jcalvinowens/ledboard/prod/v020-BOM.csv

ID | Name | Designator | Footprint | Quantity | Manufacturer Part | Manufacturer | Supplier | Supplier Part | Price
1 | 4.7uH | L1 | IND-SMD_L7.0-W6.6 | 1 | MWSA0603S-4R7MT | Sunlord(顺络) | LCSC | C408447 | 0.015
2 | HL-A-3014H416W-S1-08HL-HR3_C210338 | LED1,LED2,LED3,LED4,LED5,LED6,LED7,LED8,LED9,LED10,LED11,LED12,LED13,LED14,LED15,LED16,LED17,LED18,LED19,LED20,LED21,LED22,LED23,LED24,LED25,LED26,LED27,LED28,LED29,LED30,LED31,LED32,LED33,LED34,LED35,LED36,LED37,LED38,LED39,LED40,LED41,LED42,LED43,LED44,LED45,LED46,LED47,LED48,LED49,LED50,LED51,LED52,LED53,LED54,LED55,LED56,LED57,LED58,LED59,LED60,LED61,LED62,LED63,LED64,LED65,LED66,LED67,LED68,LED69,LED70,LED71,LED72,LED73,LED74,LED75,LED76,LED77,LED78,LED79,LED80,LED81,LED82,LED83,LED84,LED85,LED86,LED87,LED88,LED89,LED90,LED91,LED92,LED93,LED94,LED95,LED96,LED97,LED98,LED99,LED100,LED101,LED102,LED103,LED104,LED105,LED106,LED107,LED108,LED109,LED110,LED111,LED112,LED113,LED114,LED115,LED116,LED117,LED118,LED119,LED120,LED121,LED122,LED123,LED124,LED125,LED126,LED127,LED128 | LED3014-RD | 128 | HL-A-3014H416W-S1-08HL-HR3 | Hongli Zhihui (HONGLITRONIC) | LCSC | C210338 | 0.002
3 | HL-A-3014H416W-S1-08HL-HR3_C210338 | LED129,LED130,LED131,LED132,LED133,LED134,LED135,LED136,LED137,LED138,LED139,LED140,LED141,LED142,LED143,LED144,LED145,LED146,LED147,LED148,LED149,LED150,LED151,LED152,LED153,LED154,LED155,LED156,LED157,LED158,LED159,LED160,LED161,LED162,LED163,LED164,LED165,LED166,LED167,LED168,LED169,LED170,LED171,LED172,LED173,LED174,LED175,LED176,LED177,LED178,LED179,LED180,LED181,LED182,LED183,LED184,LED185,LED186,LED187,LED188,LED189,LED190,LED191,LED192,LED193,LED194,LED195,LED196,LED197,LED198,LED199,LED200,LED201,LED202,LED203,LED204,LED205,LED206,LED207,LED208,LED209,LED210,LED211,LED212,LED213,LED214,LED215,LED216,LED217,LED218,LED219,LED220,LED221,LED222,LED223,LED224,LED225,LED226,LED227,LED228,LED229,LED230,LED231,LED232,LED233,LED234,LED235,LED236,LED237,LED238,LED239,LED240,LED241,LED242,LED243,LED244,LED245,LED246,LED247,LED248,LED249,LED250,LED251,LED252,LED253,LED254,LED255,LED256 | LED3014-RD | 128 | HL-A-3014H416W-S1-08HL-HR3 | Hongli Zhihui (HONGLITRONIC) | LCSC | C210338 | 0.002
4 | HL-A-3014H416W-S1-08HL-HR3_C210338 | LED257,LED258,LED259,LED260,LED261,LED262,LED263,LED264,LED265,LED266,LED267,LED268,LED269,LED270,LED271,LED272,LED273,LED274,LED275,LED276,LED277,LED278,LED279,LED280,LED281,LED282,LED283,LED284,LED285,LED286,LED287,LED288,LED289,LED290,LED291,LED292,LED293,LED294,LED295,LED296,LED297,LED298,LED299,LED300,LED301,LED302,LED303,LED304,LED305,LED306,LED307,LED308,LED309,LED310,LED311,LED312,LED313,LED314,LED315,LED316,LED317,LED318,LED319,LED320,LED321,LED322,LED323,LED324,LED325,LED326,LED327,LED328,LED329,LED330,LED331,LED332,LED333,LED334,LED335,LED336,LED337,LED338,LED339,LED340,LED341,LED342,LED343,LED344,LED345,LED346,LED347,LED348,LED349,LED350,LED351,LED352,LED353,LED354,LED355,LED356,LED357,LED358,LED359,LED360,LED361,LED362,LED363,LED364,LED365,LED366,LED367,LED368,LED369,LED370,LED371,LED372,LED373,LED374,LED375,LED376,LED377,LED378,LED379,LED380,LED381,LED382,LED383,LED384 | LED3014-RD | 128 | HL-A-3014H416W-S1-08HL-HR3 | Hongli Zhihui (HONGLITRONIC) | LCSC | C210338 | 0.002
5 | 2N7002AK | Q1,Q10,Q19,Q28,Q37,Q46,Q55,Q64,Q2,Q3,Q4,Q5,Q6,Q7,Q8,Q9,Q11,Q12,Q13,Q14,Q15,Q16,Q17,Q18,Q20,Q21,Q22,Q23,Q24,Q25,Q26,Q27,Q29,Q30,Q31,Q32,Q33,Q34,Q35,Q36,Q38,Q39,Q40,Q41,Q42,Q43,Q44,Q45,Q47,Q48,Q49,Q50,Q51,Q52,Q53,Q54,Q56,Q57,Q58,Q59,Q60,Q61,Q62,Q63 | SOT-23_L2.9-W1.3-P1.90-LS2.4-BR | 64 | 2N7002AK | YFW(佑风微) | LCSC | C2898356 | 0.003
6 | AP2301B | Q65,Q66,Q67,Q68,Q69,Q70 | SOT-23-3_L2.9-W1.3-P1.90-LS2.4-TR | 6 | AP2301B | ALLPOWER(铨力) | LCSC | C2763847 | 0.003
7 | 3.3K | R1,R10,R19,R28,R37,R46,R55,R64,R2,R3,R4,R5,R6,R7,R8,R9,R11,R12,R13,R14,R15,R16,R17,R18,R20,R21,R22,R23,R24,R25,R26,R27,R29,R30,R31,R32,R33,R34,R35,R36,R38,R39,R40,R41,R42,R43,R44,R45,R47,R48,R49,R50,R51,R52,R53,R54,R56,R57,R58,R59,R60,R61,R62,R63 | R0402 | 64 | RC0402FR-073K3L | YAGEO(国巨) | LCSC | C137992
8 | 2K | R65,R66,R67,R68,R69,R70 | R0402 | 6 | RC0402FR-072KL | YAGEO | LCSC | C60488
9 | 20kΩ | R73 | R0402 | 1 | 0402WGF2002TCE | UniOhm | LCSC | C25765
10 | 100kΩ | R71 | R0603 | 1 | ARG03BTC1003 | 光颉(Viking) | LCSC | C335088 | 0.003
11 | 50kΩ | R72 | RES-ADJ-SMD_3314G-1-103E | 1 | 3314G-1-503E | BOURNS | LCSC | C719184 | 0.088
12 | 74HC595D,118 | U5,U6,U7,U8,U9,U10,U11,U12 | SOIC-16_L9.9-W3.9-P1.27-LS6.0-BL | 8 | 74HC595D,118 | Nexperia(安世) | LCSC | C5947 | 0.03
13 | 12MHz | X1 | OSC-SMD_4P-L3.2-W2.5-BL | 1 | X322512MOB4SI | YXC | LCSC | C70565 | 0.013
14 | 100nF | C1,C2,C3,C4,C5 | C0603 | 5 | CC0603KRX7R9BB104 | YAGEO | LCSC | C14663
15 | 15pF | C6,C7 | C0805 | 2 | CC0805JRNPO9BN150 | YAGEO | LCSC | C107110 | 0.001
16 | 22uF | C8,C11,C12 | C1210 | 3 | GRM32ER61E226KE15L | MuRata | LCSC | C65428 | 0.041
17 | 10uF | C9 | C1206 | 1 | CS3216X5R106K500NRI | Samwha Capacitor | LCSC | C513774 | 0.007
18 | 22nF | C10 | C0603 | 1 | CL10B223KB8NNNC | SAMSUNG | LCSC | C21122 | 0.001
19 | STM32F030C8T6 | U1 | LQFP-48_L7.0-W7.0-P0.50-LS9.0-BL | 1 | STM32F030C8T6 | ST | LCSC | C23922 | 0.194
20 | AMS1117-3.3_C165482 | U2 | SOT-223_L6.5-W3.5-P2.30-LS7.0-BR | 1 | AMS1117-3.3 | SK | LCSC | C165482 | 0.012
21 | MT2492 | U3 | SOT-23-6_L2.9-W1.6-P0.95-LS2.8-BR | 1 | MT2492 | AEROSEMI | LCSC | C89358 | 0.01
