jcalvinowens/ledboard/prod/v020-SCHEMATIC.pdf

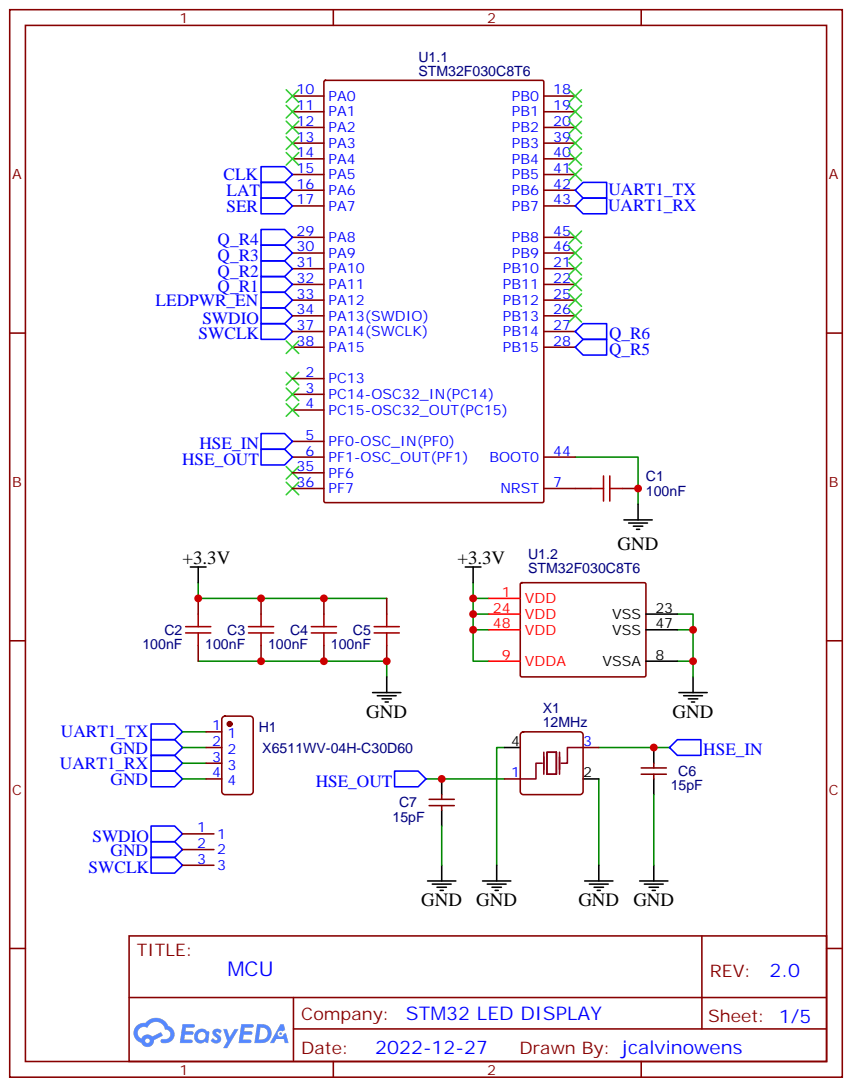
[picture p3: page 1]

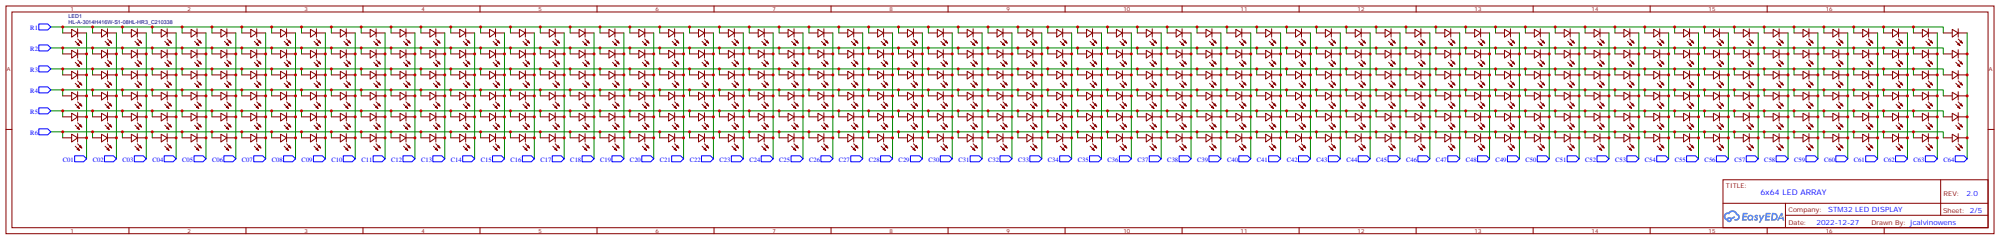
[picture p4: page 2]

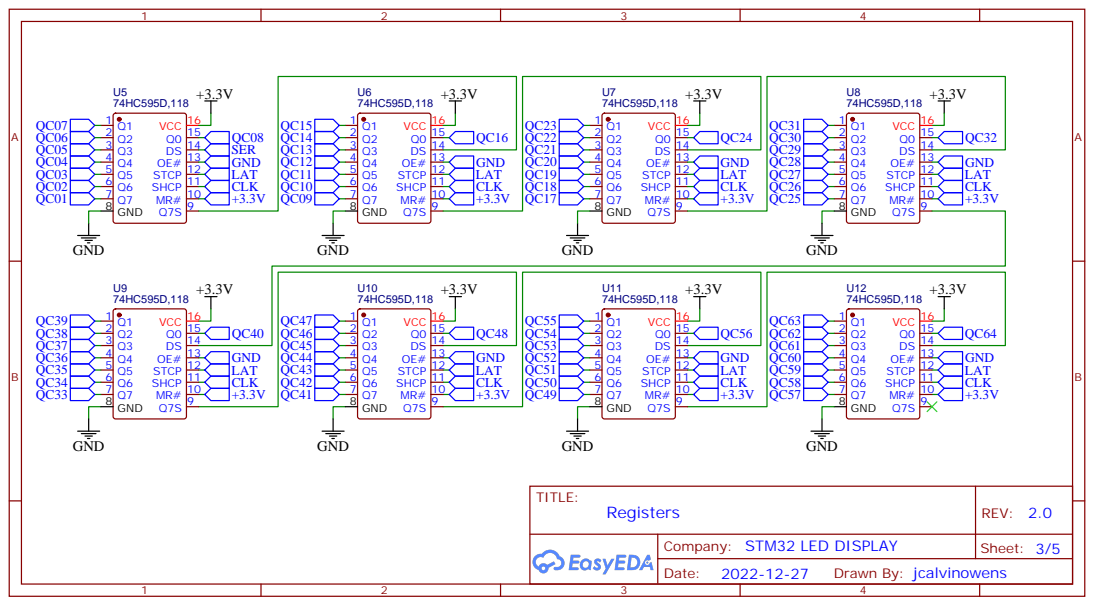
[picture p5: page 3]

MR# 10 SHCP 11 STCP 12 OE# 13 DS 14 Q0 15 VCC 16

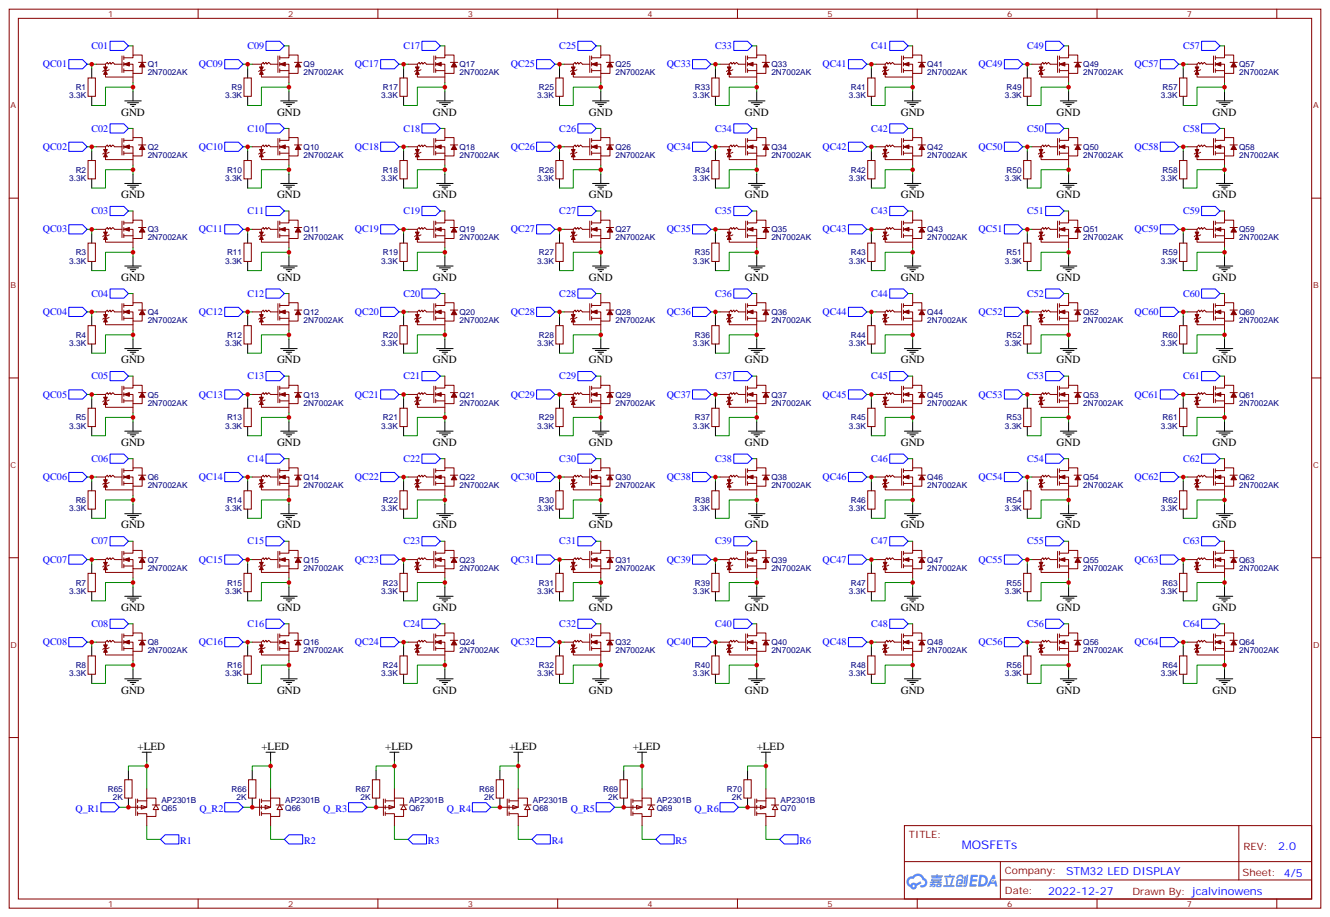
[picture p6: page 4]

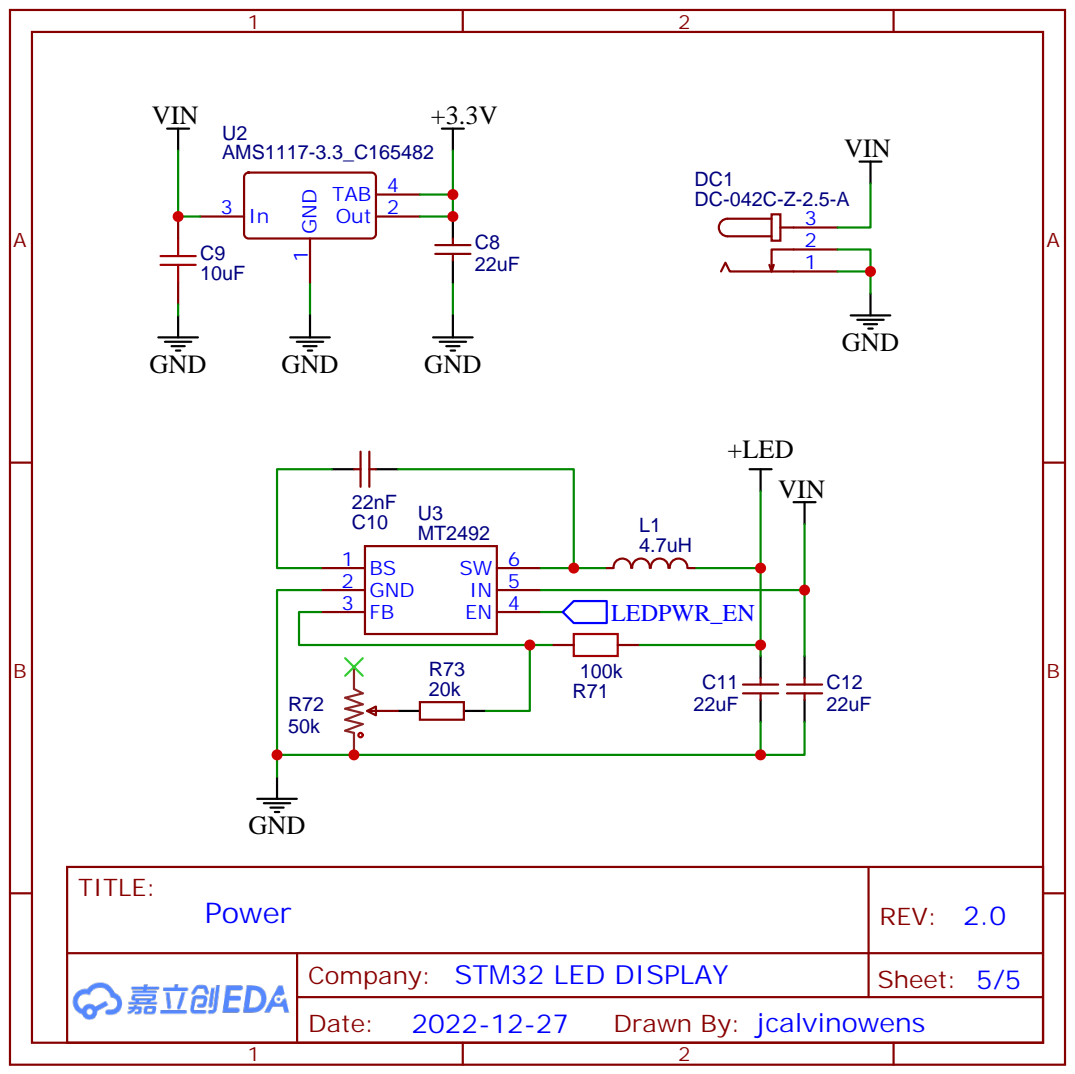
[picture p7: page 5]
