jcalvinowens/ledboard/ledfont.py

# This 6x4 font is from lib/fonts/font_mini_4x6.c in the Linux kernel.
# https://elixir.bootlin.com/linux/latest/source/lib/fonts/font_mini_4x6.c

FONTTABLE = [
[ # 0 == ' '
[0,0,0,0],
[0,0,0,0],
[0,0,0,0],
[0,0,0,0],
[0,0,0,0],
[0,0,0,0],
],
[ # 1 == '!'
[0,1,0,0],
[0,1,0,0],
[0,1,0,0],
[0,0,0,0],
[0,1,0,0],
[0,0,0,0],
],
[ # 2 == '"'
[1,0,1,0],
[1,0,1,0],
[0,0,0,0],
[0,0,0,0],
[0,0,0,0],
[0,0,0,0],
],
[ # 3 == '#'
[1,0,1,0],
[1,1,1,1],
[1,1,1,1],
[1,0,1,0],
[0,0,0,0],
[0,0,0,0],
],
[ # 4 == '$'
[0,1,0,0],
[0,1,1,0],
[1,1,1,0],
[1,1,0,0],
[0,1,0,0],
[0,0,0,0],
],
[ # 5 == '%'
[1,0,1,0],
[0,0,1,0],
[0,1,0,0],
[1,0,0,0],
[1,0,1,0],
[0,0,0,0],
],
[ # 6 == '&'
[0,1,1,0],
[1,0,0,1],
[0,1,1,0],
[1,0,1,0],
[1,1,0,1],
[0,0,0,0],
],
[ # 7 == '''
[0,0,1,0],
[0,1,0,0],
[0,0,0,0],
[0,0,0,0],
[0,0,0,0],
[0,0,0,0],
],
[ # 8 == '('
[0,0,1,0],
[0,1,0,0],
[0,1,0,0],
[0,1,0,0],
[0,0,1,0],
[0,0,0,0],
],
[ # 9 == ')'
[0,1,0,0],
[0,0,1,0],
[0,0,1,0],
[0,0,1,0],
[0,1,0,0],
[0,0,0,0],
],
[ # 10 == '*'
[0,0,0,0],
[1,1,1,0],
[1,1,1,0],
[1,1,1,0],
[0,0,0,0],
[0,0,0,0],
],
[ # 11 == '+'
[0,0,0,0],
[0,1,0,0],
[1,1,1,0],
[0,1,0,0],
[0,0,0,0],
[0,0,0,0],
],
[ # 12 == ','
[0,0,0,0],
[0,0,0,0],
[0,0,0,0],
[0,1,0,0],
[1,0,0,0],
[0,0,0,0],
],
[ # 13 == '-'
[0,0,0,0],
[0,0,0,0],
[1,1,1,0],
[0,0,0,0],
[0,0,0,0],
[0,0,0,0],
],
[ # 14 == '.'
[0,0,0,0],
[0,0,0,0],
[0,0,0,0],
[0,0,0,0],
[0,1,0,0],
[0,0,0,0],
],
[ # 15 == '/'
[0,0,0,0],
[0,0,1,0],
[0,1,0,0],
[1,0,0,0],
[0,0,0,0],
[0,0,0,0],
],
[ # 16 == '0'
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
[0,1,0,0],
[0,1,0,0],
[0,1,0,0],
[0,0,0,0],
],
[ # 93 == '}'
[1,0,0,0],
[0,1,0,0],
[0,1,1,0],
[0,1,0,0],
[1,0,0,0],
[0,0,0,0],
],
[ # 94 == '~'
[0,1,0,1],
[1,0,1,0],
[0,0,0,0],
[0,0,0,0],
[0,0,0,0],
[0,0,0,0],
],
[ # 95 == BOX
[1,1,1,1],
[1,1,1,1],
[1,1,1,1],
[1,1,1,1],
[1,1,1,1],
[1,1,1,1],
],
]
