jcalvinowens/ledboard/(notices)

Notices in the files:
driver.py:
with this work. If not, see http://creativecommons.org/publicdomain/zero/1.0
